Vaticori/chipalooza3-ldo-gf180/simulations/results/summary.md

# Simulation results (schematic, pre-layout)

Generated by `simulations/run_sims.py`. Typical corner, 27 C, VIN = 5.0 V, VREF = 1.2 V,
EN = 3.3 V (harness logic level), CL = 2 pF, unless noted.

| Parameter | Spec | Simulated | Result | Testbench |
|---|---|---|---|---|
| Output voltage (5 mA) | 3.201 - 3.399 V | 3.3091 V | PASS | tb_load_reg |
| Dropout (10 mA) | <= 300 mV | 152 mV | PASS | tb_dropout |
| Quiescent current (no load) | <= 100 uA | 62.4 uA | PASS | tb_iq |
| Line regulation (4.5-5.5 V, 5 mA) | <= 1.0 % | 0.042 % | PASS | tb_line_reg |
| Load regulation (0-10 mA) | <= 1.0 % | 0.270 % | PASS | tb_load_reg |
| PSRR (100 Hz, 5 mA) | >= 40 dB | 59.0 dB | PASS | tb_psrr |
| PSRR (10 kHz / 1 MHz) | - | 44.0 / 5.3 dB | info | tb_psrr |
| Load step 0->10 mA, 1 us | - | -209 / +312 mV | info | tb_tran_load |
| Line step 5.0->4.5 V, 1 us | - | -54 / +52 mV | info | tb_tran_line |
| EN off -> VOUT | 0 V | 0.00 mV | PASS | tb_en |
| EN turn-on time (to 3.2 V) | - | 1.63 us | info | tb_en |
| EN switching threshold | 3.3 V logic | 1.38 / 1.57 V (VIN 4.5 / 5.5) | PASS | tb_en_dc |
| Shutdown current (EN = 0) | - | 46.5 uA | info | tb_iq |

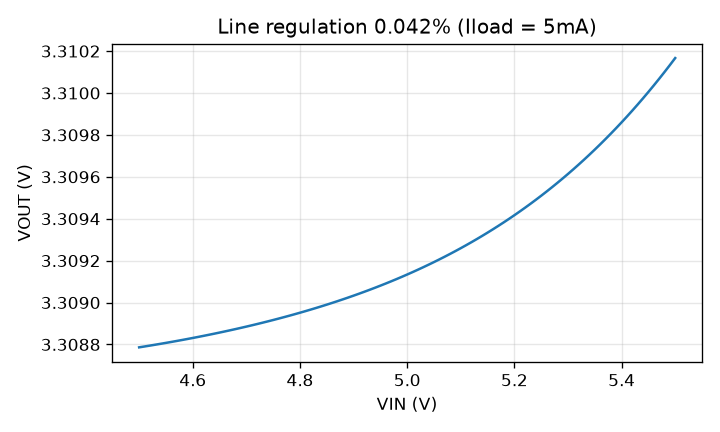
[picture p1: simulations/results/line_reg.png]
line regulation
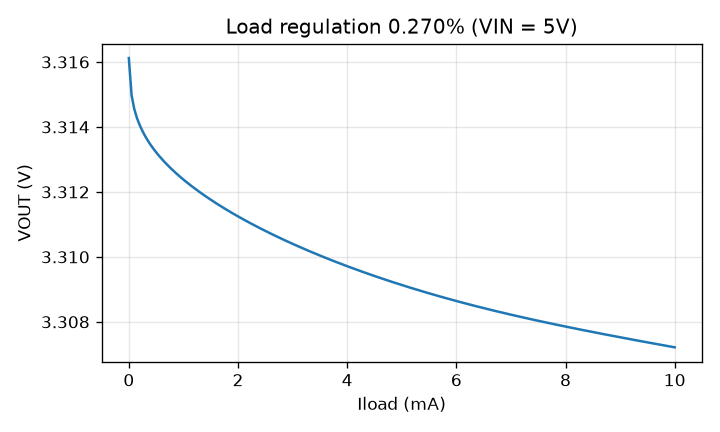
[picture p2: simulations/results/load_reg.png]
load regulation
 
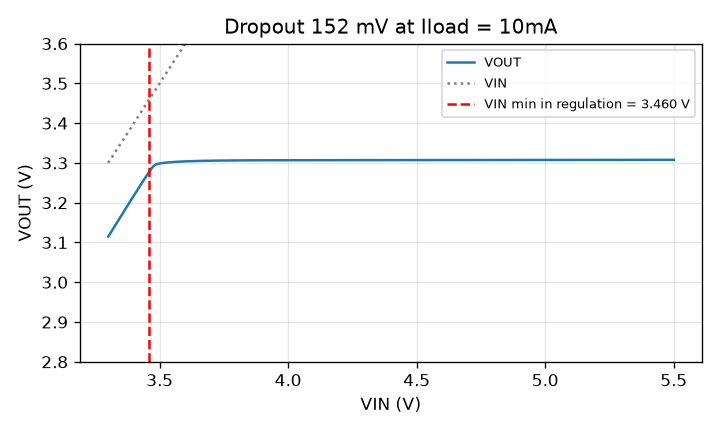
[picture p3: simulations/results/dropout.png]
dropout
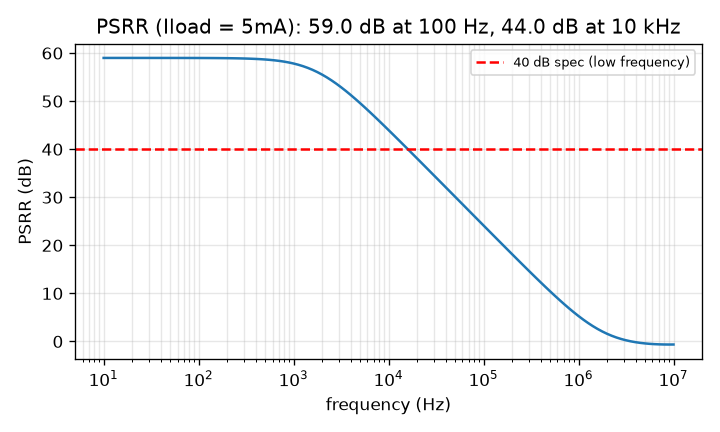
[picture p4: simulations/results/psrr.png]
PSRR
 
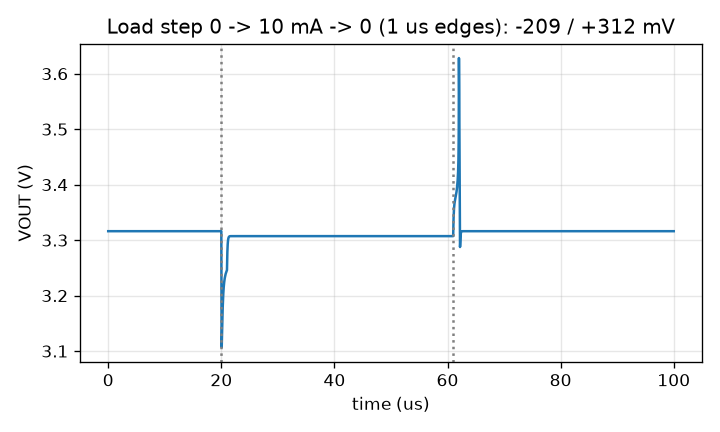
[picture p5: simulations/results/tran_load.png]
load transient
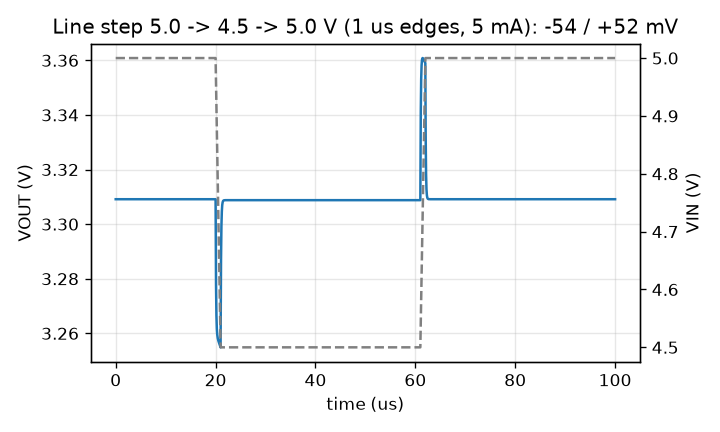
[picture p6: simulations/results/tran_line.png]
line transient
 
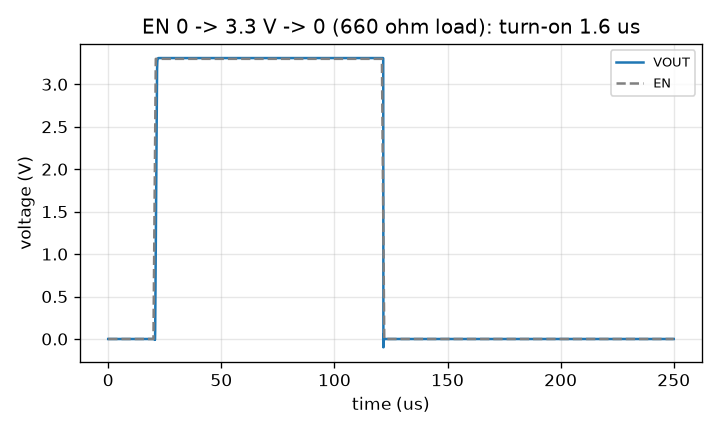
[picture p7: simulations/results/en.png]
EN transient
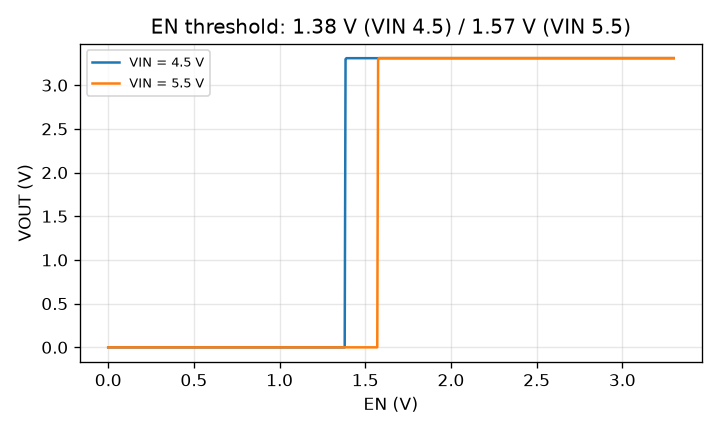
[picture p8: simulations/results/en_dc.png]
EN threshold
 

## Process corners x temperature (VIN = 5.0 V)

MOS corners tt/ff/ss/fs/sf x poly-resistor and MIM-capacitor corners typical/ff/ss x -40/27/110 C.

| MOS corner | R/C corner | Temp (C) | VOUT @5 mA (V) | Iq (uA) | Line reg (%) | Load reg (%) | Dropout @10 mA (mV) | PSRR @100 Hz (dB) |
|---|---|---|---|---|---|---|---|---|
| typical | typical | -40 | 3.3089  | 54.9  | 0.032  | 0.206  | 107  | 61.5  |
| typical | typical | 27 | 3.3091  | 62.4  | 0.042  | 0.270  | 152  | 59.0  |
| typical | typical | 110 | 3.3098  | 71.2  | 0.052  | 0.388  | 207  | 56.9  |
| typical | ff | -40 | 3.3094  | 67.3  | 0.038  | 0.213  | 107  | 59.9  |
| typical | ff | 27 | 3.3099  | 76.6  | 0.048  | 0.286  | 152  | 57.6  |
| typical | ff | 110 | 3.3110  | 87.4  | 0.059  | 0.437  | 206  | 55.7  |
| typical | ss | -40 | 3.3086  | 46.5  | 0.028  | 0.201  | 108  | 62.8  |
| typical | ss | 27 | 3.3086  | 52.8  | 0.037  | 0.260  | 153  | 60.2  |
| typical | ss | 110 | 3.3089  | 60.3  | 0.046  | 0.362  | 208  | 58.0  |
| ff | typical | -40 | 3.3083  | 60.1  | 0.044  | 0.201  | 83  | 58.5  |
| ff | typical | 27 | 3.3087  | 68.2  | 0.057  | 0.276  | 122  | 56.2  |
| ff | typical | 110 | 3.3095  | 77.8  | 0.071  | 0.597  | 167  | 54.1  |
| ff | ff | -40 | 3.3088  | 73.6  | 0.051  | 0.211  | 82  | 57.2  |
| ff | ff | 27 | 3.3096  | 83.5  | 0.065  | 0.297  | 122  | 55.0  |
| ff | ff | 110 | 3.3109  | 95.2  | 0.081  | 0.809  | 166  | 52.9  |
| ff | ss | -40 | 3.3079  | 51.1  | 0.039  | 0.195  | 83  | 59.6  |
| ff | ss | 27 | 3.3081  | 57.9  | 0.051  | 0.263  | 123  | 57.2  |
| ff | ss | 110 | 3.3086  | 66.0  | 0.063  | 0.491  | 168  | 55.2  |
| ss | typical | -40 | 3.3096  | 51.1  | 0.020  | 0.217  | 137  | 66.3  |
| ss | typical | 27 | 3.3097  | 58.1  | 0.026  | 0.278  | 192  | 63.6  |
| ss | typical | 110 | 3.3102  | 66.2  | 0.031  | 0.369  | 262  | 61.7  |
| ss | ff | -40 | 3.3100  | 62.5  | 0.023  | 0.223  | 136  | 65.0  |
| ss | ff | 27 | 3.3104  | 71.1  | 0.028  | 0.290  | 191  | 62.9  |
| ss | ff | 110 | 3.3113  | 81.0  | 0.031  | 0.393  | 261  | 61.7  |
| ss | ss | -40 | 3.3093  | 43.3  | 0.018  | 0.214  | 137  | 67.6  |
| ss | ss | 27 | 3.3092  | 49.1  | 0.023  | 0.270  | 192  | 64.7  |
| ss | ss | 110 | 3.3095  | 56.1  | 0.028  | 0.354  | 263  | 62.5  |
| fs | typical | -40 | 3.3097  | 57.5  | 0.017  | 0.208  | 132  | 67.3  |
| fs | typical | 27 | 3.3101  | 65.5  | 0.023  | 0.269  | 187  | 64.1  |
| fs | typical | 110 | 3.3109  | 74.9  | 0.029  | 0.370  | 251  | 61.8  |
| fs | ff | -40 | 3.3103  | 70.6  | 0.021  | 0.215  | 131  | 65.2  |
| fs | ff | 27 | 3.3110  | 80.4  | 0.027  | 0.284  | 186  | 62.5  |
| fs | ff | 110 | 3.3123  | 91.9  | 0.032  | 0.408  | 245  | 60.8  |
| fs | ss | -40 | 3.3093  | 48.7  | 0.014  | 0.203  | 132  | 69.4  |
| fs | ss | 27 | 3.3095  | 55.4  | 0.020  | 0.260  | 187  | 65.6  |
| fs | ss | 110 | 3.3100  | 63.4  | 0.026  | 0.348  | 252  | 62.9  |
| sf | typical | -40 | 3.3083  | 53.0  | 0.052  | 0.210  | 87  | 57.1  |
| sf | typical | 27 | 3.3085  | 59.9  | 0.065  | 0.281  | 123  | 55.1  |
| sf | typical | 110 | 3.3090  | 68.2  | 0.079  | 0.445  | 173  | 53.2  |
| sf | ff | -40 | 3.3087  | 64.8  | 0.058  | 0.218  | 87  | 56.0  |
| sf | ff | 27 | 3.3092  | 73.4  | 0.072  | 0.297  | 122  | 54.1  |
| sf | ff | 110 | 3.3101  | 83.5  | 0.087  | 0.521  | 172  | 52.4  |
| sf | ss | -40 | 3.3080  | 45.0  | 0.046  | 0.205  | 88  | 58.1  |
| sf | ss | 27 | 3.3080  | 50.8  | 0.058  | 0.270  | 123  | 56.0  |
| sf | ss | 110 | 3.3082  | 57.8  | 0.072  | 0.404  | 168  | 54.1  |
