Vaticori/chipalooza3-ldo-gf180/(commit log)

2026-10-08 Capless LDO for GF180MCU: main schematic and proposal
    [LDO_GF180_MAIN.sch]
2026-10-08 Add IP block schematic, EN level shifter, testbenches and simulation results
    - xschem/ldo.sch + ldo.sym: LDO as a reusable block with pins
    (VIN, VREF, EN, VOUT, FB_BUF, EAOUT_BUF, VSS)
    - xschem/ldo_levelshift.sch: 3.3V-logic EN to VIN-domain level shifter;
    EN previously could not disable MENPASSOFF from 3.3V logic
    - simulations/: one testbench per test-plan item, run_sims.py to run them
    all, plots and spec summary incl. process corners x -40/27/110 C
    - netlist/schematic/ldo.spice: exported schematic netlist
    - README: harness resources, results, reproduction steps, open items
    [ldo.sch, ldo_levelshift.sch, tb_dropout.sch, tb_en.sch, tb_en_dc.sch, tb_iq.sch, tb_line_reg.sch, tb_load_reg.sch]
2026-10-08 Use GF180MCU PDK resistors and MIM capacitor; add R/C corners
    - Rref, RrefFB, RrefEA, R1, R2 -> ppolyf_u_2k_6p0 (5V-domain hi-res poly);
    Cc -> cap_mim_2f0fF, top plate on EAOUT, bottom plate on VOUT
    - RrefFB/RrefEA (test-buffer bias) 1M -> 2M: with PDK resistors, Iq hit
    111 uA at fast-resistor/110C; now 95 uA worst, 62 uA typical
    - Testbenches load res/mim model sections; run_sims.py sweeps MOS x R/C
    corners x temperature (45 combinations), all specs pass
    [ldo.sch, tb_dropout.sch, tb_en.sch, tb_en_dc.sch, tb_iq.sch, tb_line_reg.sch, tb_load_reg.sch, tb_psrr.sch]
2026-10-09 README: drop License section; ldo.sch: fix stale wire label on EN_5V net (no netlist change)
    [ldo.sch]
